WurdahMekanik/BOTS/README.md

BOTS
====

Line-tracking sketches &amp; other assorted robotics competition info
