WurdahMekanik/BOTS/(commit log)

2013-04-22 Set a few commands for motor control, and added HCF routine for when things go horribly wrong.
2013-04-26 ========= =CHANGES= ========= `Merged grappling routine into /RobotWorking1/RobotBasic/RobotBasic4/ directory `Added grappling switch pin, tilt switch pin & masks `Updated the intialization in setup(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
    ======
    =TODO=
    ======
    `Add tilt switch masking in setup()
    `Add straightLine() routine
    `Fix loop() to reflect aforementioned future changes
    `????
    `PROFIT!
2013-04-26 CHANGES: `Added tilt switch check in setup() `Added straightLine() routine `Updated main loop() to reflect changes
    TODO:
    `Tweak
    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
2013-04-26 Uhh... forgot to switch between sensors based on tilt switch status. I'm tired.
2013-04-27 Fixed the lineTracking() sensor reads
2013-06-24 Fixes an unintended merge and some other code
    [RobotFinalCommands.h]
